daniel26127143/2wheelbalancecar/stable/README.md

### Latest Stable Release

**Recommended:**  👉 [**v0.2**](./v0.2) (Verified balance core)

* [v0.1 (Legacy Prototype)](./v0.1)
