daniel26127143/2wheelbalancecar/stable/v0.1/readme.md

# beta_v1: 不會倒下

# 此版本CODE已經可以達成自平衡小車的基礎穩定功能，並使用5ms的中斷系統。小車已能在室內環境中長時間保持平衡。

---

##  版本重點功能與成果

-   **系統穩定性：** 在 Kp, Ki, Kd 參數精確調校後，小車已實現**長時間穩定站立**（可維持 10 分鐘以上不倒）。
-   **控制核心：** 採用 **5ms Timer 中斷 (ISR)** 架構，確保 PID 運算精準且即時，避免了主迴圈 (Loop) I2C 通訊延遲的干擾。
-   **初版流程圖：** 提供了當前控制邏輯的初版流程圖作為後續優化的參考。

---

##  與教授討論後能夠改善的地方

此 beta 版本是未來進階控制的基礎所以是beta_v1。根據討論，未來會針對**控制連續性**和**效能監控**的優化方向：

### 1. 控制邏輯強化與角度判斷(流程圖方面)

-   **待優化項目：** 將 `Loop()` 與 `ISR` 中檢查是否傾倒的邏輯，統一改為**判斷角度是否超過預設閾值**來執行相應的動作，還有在中斷功能要檢查是否溢位。
-   **目標：** 讓判斷邏輯更精確，與控制系統高度整合。

### 2. 在ISR當中進行迴圈並且直接獲取MPU6050的角度(程式碼方面)

-   **待優化項目：** 嘗試在 **ISR 內部新增迴圈**，讓 PID 運算**持續執行**直到小車被拉回平衡點後才返回 `Loop()`。
-   **挑戰：** 需解決在 ISR 內**阻塞**、等待最新角度數據（DMP）的問題，避免破壞 5ms 的控制時序。

### 3. 效能與延遲監控

-   **監控機制：** 計劃使用 **LED** 來判斷 ISR 是否正常返回 `Loop()`，並透過觀察 LED 閃爍頻率來**計算 ISR 的實際工作時長**。

---
以下是本次測試的Youtube影片
https://www.youtube.com/watch?v=9Uyl_yrKQsg
