daniel26127143/2wheelbalancecar/flow/流程圖02.drawio.png

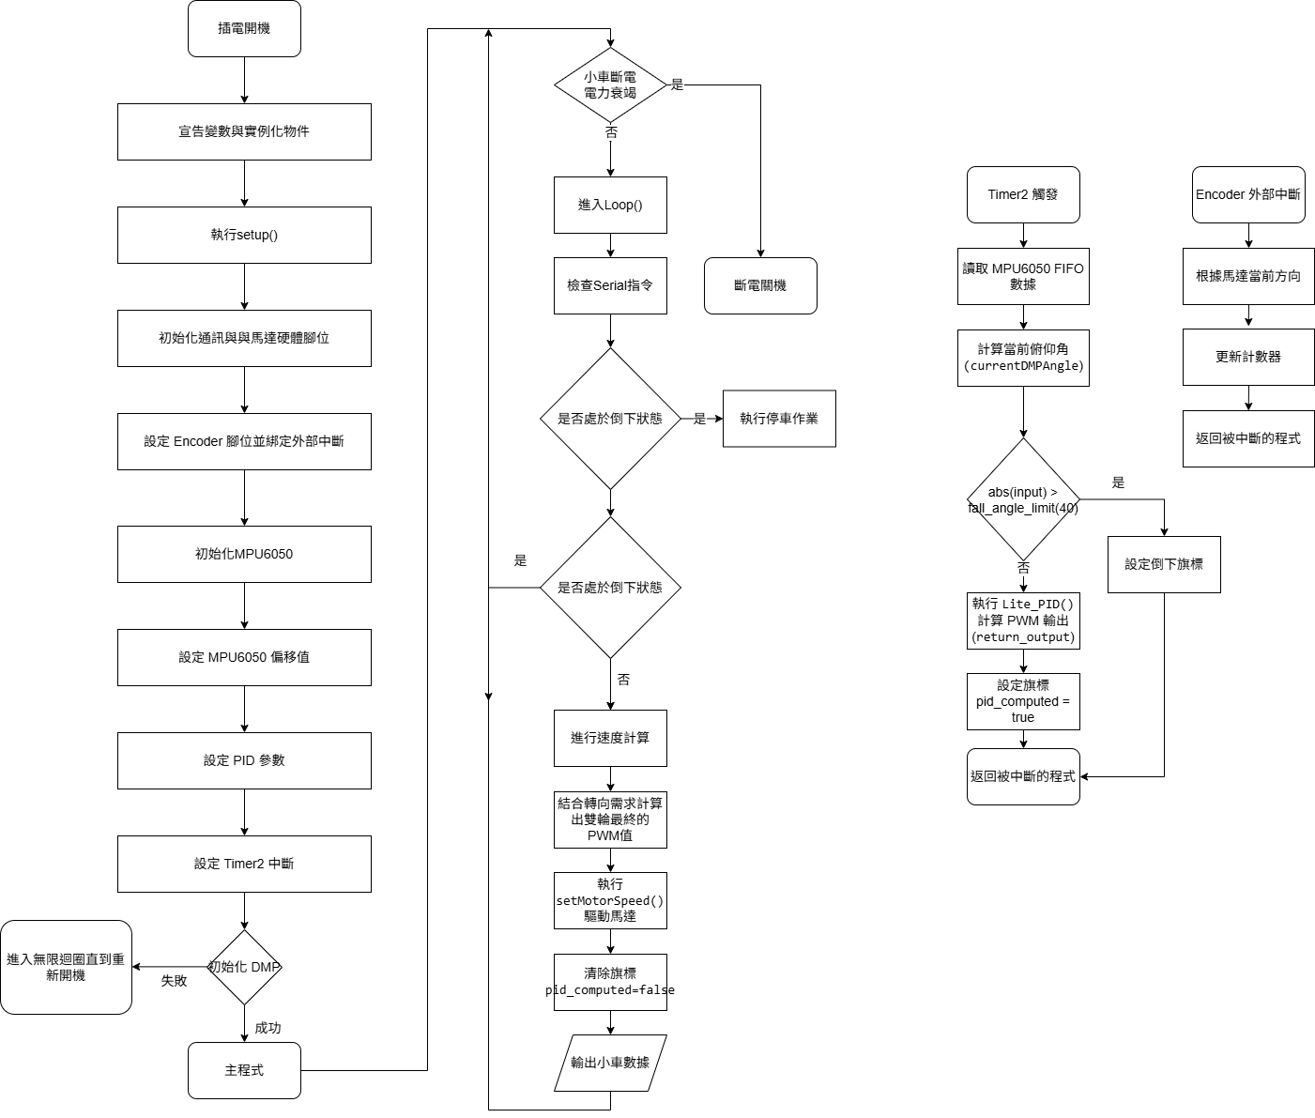
flow/流程圖02.drawio.png
