daniel26127143/2wheelbalancecar/python/logs/autotest_results.csv

time | label | vmax | vback | vmin | vmin_back | kp | kd | steer | hold | cycle | phase | n | speed_mean_cms | speed_sd_cms | speed_peak_cms | sa_sat_pct | pwm_mean | overshoot | emerg | fell | log | yaw_cmd | yaw_mean | yaw_sd | yaw_ratio
2026-10-13 21:17:21 | v34 | 7.2 | 3.5 | 6.5 | 3.0 | 2.8 | 40.0 | 0.0 | 5.0 | 1 | W | 17 | 3.482628983658124 | 3.5282171945574925 | 10.299433872177886 | 0.0 | 22.941176470588236 | 2.236111111111111 | 0 | 0 | telemetry_20261013_211706.csv
2026-10-13 21:17:48 | v34 | 7.2 | 3.5 | 6.5 | 3.0 | 2.8 | 40.0 | 0.0 | 5.0 | 1 | W | 17 | 4.048355581233925 | 3.8268114051558664 | 9.8219766728054 | 0.0 | 25.941176470588236 | 2.0 | 0 | 0 | telemetry_20261013_211706.csv
2026-10-13 21:18:09 | v34 | 7.2 | 3.5 | 6.5 | 3.0 | 2.8 | 40.0 | 0.0 | 5.0 | 1 | W | 17 | 3.2057840529295403 | 1.7512060729127128 | 6.8890253052315655 | 0.0 | 20.0 | 1.472222222222222 | 0 | 0 | telemetry_20261013_211706.csv
2026-10-13 21:33:05 | x35 | 7.2 | 3.5 | 6.5 | 3.0 | 2.8 | 40.0 | 0.0 | 6.0 | 1 | X | 22 | 2.663219053642626 | 3.472378624686737 | 9.003478616738283 | 0.0 | 21.272727272727273 | 3.7714285714285714 | 0 | 0 | telemetry_20261013_213248.csv
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
