daniel26127143/2wheelbalancecar/Experiments/testyawpitchrow.ino

#include <Wire.h>
#include "I2Cdev.h"
#include "MPU6050_6Axis_MotionApps20.h"
#include <PID_v1.h>
// 徑度角度的轉換常數
//const float DEG_TO_RAD = 0.0174533f; // (PI / 180.0) 因為原本就有定義了 重新定義會出錯先註解

// 分區 PWM 設定
float zone1_limit = 2 * DEG_TO_RAD;        // |input| < 2
float zone2_limit = 3 * DEG_TO_RAD;        // |input| < 3
float zone1_gain = 0.95;                   // 小角度修正比較弱
float zone2_gain = 1.0;                    // 中角度修正稍強
float zone3_gain = 1.1;                    // 大角度修正更強
float fall_angle_limit = 40 * DEG_TO_RAD;  // 超過 ±40 度就停車

// 用於扶正回復時的計數器
unsigned long recovery_counter = 0;

// MPU6050 與 DMP
MPU6050 mpu;
bool dmpReady = false;
uint8_t devStatus;
uint16_t packetSize;
uint16_t fifoCount;
uint8_t fifoBuffer[64];

// ISR 所需要的回傳值
volatile float return_output = 0.0;
volatile bool pid_computed = false;

// led 定義
const int led = A0;
Quaternion q;
VectorFloat gravity;
float ypr[3];

// 用於ISR和Loop中傳遞當前的角度和小車已倒下旗標
volatile float currentDMPAngle = 0.0;
volatile float currentYaw = 0.0;
volatile float currentPitch = 0.0;
volatile float currentRoll = 0.0;
volatile bool is_fallen = false;
int current_zone = 0;

// PID
double input, output, setpoint = -2.3 * DEG_TO_RAD;  // 電源線反方向設定
// double Kp = 50.0, Ki = 200, Kd = 2.4;   // 角度的
double Kp = 2350.0, Ki = 11459.0, Kd = 137.4;  // 更改為徑度的
PID pid(&input, &output, &setpoint, Kp, Ki, Kd, DIRECT);

// 馬達腳位
#define IN1M 7
#define IN2M 6
#define PWMA 9
#define IN3M 13
#define IN4M 12
#define PWMB 10
#define STBY 8

void initMotorPins() {
  pinMode(IN1M, OUTPUT);
  pinMode(IN2M, OUTPUT);
  pinMode(PWMA, OUTPUT);
  pinMode(IN3M, OUTPUT);
  pinMode(IN4M, OUTPUT);
  pinMode(PWMB, OUTPUT);
  pinMode(STBY, OUTPUT);
  digitalWrite(STBY, HIGH);
}

void stop() {
  setMotorSpeed(0);
}

void setMotorSpeed(float speed) {
  speed = constrain(speed, -255, 255);
  int pwm = abs(speed);
  if (pwm < 5) pwm = 0;

  if (speed < 0) {
    digitalWrite(IN1M, HIGH);
    digitalWrite(IN2M, LOW);
    digitalWrite(IN3M, HIGH);
    digitalWrite(IN4M, LOW);
  } else {
    digitalWrite(IN1M, LOW);
    digitalWrite(IN2M, HIGH);
    digitalWrite(IN3M, LOW);
    digitalWrite(IN4M, HIGH);
  }
  analogWrite(PWMA, pwm);
  analogWrite(PWMB, pwm);
}

void setup() {
  Serial.begin(9600);  // 配合藍牙
  Wire.begin();

  //加速 I2C 到 400kHz，這是 ISR 讀取不當機的關鍵
  Wire.setClock(400000);

  initMotorPins();
  pinMode(led, OUTPUT);
  digitalWrite(led, LOW);  // 確保起始是滅的

  mpu.initialize();
  devStatus = mpu.dmpInitialize();

  mpu.setXAccelOffset(-3353);
  mpu.setYAccelOffset(97);
  mpu.setZAccelOffset(123);
  mpu.setXGyroOffset(81);
  mpu.setYGyroOffset(-30);
  mpu.setZGyroOffset(63);

  if (devStatus == 0) {
    mpu.setDMPEnabled(true);
    dmpReady = true;
    packetSize = mpu.dmpGetFIFOPacketSize();
    Serial.println("DMP 啟動完成");
  } else {
    Serial.print("DMP Fail: ");
    Serial.println(devStatus);
    while (1)
      ;
  }

  pid.SetMode(AUTOMATIC);
  pid.SetOutputLimits(-255, 255);
  pid.SetSampleTime(10);

  // TIMER2設定
  cli();
  TCCR2A = 0;
  TCCR2B = 0;
  TCNT2 = 0;
  OCR2A = 124;
  TCCR2A |= (1 << WGM21);
  TCCR2B |= (1 << CS22);
  TIMSK2 |= (1 << OCIE2A);
  sei();
}
ISR(TIMER2_COMPA_vect) {
  // 宣告中斷秒數的變數
  static int count = 0;
  count++;

  // 檢查是否到中斷時間
  if (count < 10) {
    return;
  }
  count = 0;

  // 以下進入真正的中斷
  sei();
  digitalWrite(led, HIGH);

  // 宣告用於三筆平均濾波的變數
  static float angleBuffer[3] = { 0.0, 0.0, 0.0 };
  static int idx = 0;

  // 讀取 FIFO
  fifoCount = mpu.getFIFOCount();
  if (fifoCount == 1024) {
    mpu.resetFIFO();
    digitalWrite(led, LOW);
    return;
  }

  if (mpu.dmpGetCurrentFIFOPacket(fifoBuffer)) {
    mpu.dmpGetQuaternion(&q, fifoBuffer);
    mpu.dmpGetGravity(&gravity, &q);
    float ypr_temp[3];
    mpu.dmpGetYawPitchRoll(ypr_temp, &q, &gravity);
    // 取得原始徑度
    float raw_angle = ypr_temp[2];
    currentYaw = ypr_temp[0];
    currentPitch = ypr_temp[1];
    currentRoll = ypr_temp[2];
    // 三筆平均濾波
    angleBuffer[idx] = raw_angle;
    idx = (idx + 1) % 3;
    currentDMPAngle = (angleBuffer[0] + angleBuffer[1] + angleBuffer[2]) / 3.0;

    input = currentDMPAngle;
  } else {
    digitalWrite(led, LOW);
    return;
  }

  // 判斷PID計算和是否傾倒偵測
  if (!is_fallen) {
    // 傾倒偵測 如果小車角度已經超過設定的傾倒角度 設定倒下旗標
    if (abs(input) > fall_angle_limit) {
      is_fallen = true;      // 設定倒下旗標
      return_output = 0;     // 停止馬達
      recovery_counter = 0;  // 清除回正計數器
    }
    // 計算PID並且使用分區增益
    else {
      pid.Compute();
      // 分區增益邏輯
      current_zone = 0;
      if (abs(input) < zone1_limit) {
        output *= zone1_gain;
        current_zone = 1;
      } else if (abs(input) < zone2_limit) {
        output *= zone2_gain;
        current_zone = 2;
      } else {
        output *= zone3_gain;
        current_zone = 3;
      }

      output = constrain(output, -255, 255);
      return_output = output;
    }
  }
  // 已經倒下需要判斷是否扶正，並且讓recovery_counter計數
  else {
    return_output = 0;  // 確保馬達完全不動
    // 判斷是否扶正(與中心 < 5 角度)
    if (abs(input - setpoint) < (5 * DEG_TO_RAD)) {
      recovery_counter++;  // 回復計數器++

      // 判斷是否已經扶正1秒鐘 (10ms x 100times = 1000ms)
      if (recovery_counter >= 100) {
        is_fallen = false;     // 取消傾倒狀態
        recovery_counter = 0;  // 回復計數器歸零

        // 重置 PID 積分項 (避免暴衝)
        pid.SetMode(MANUAL);
        pid.SetMode(AUTOMATIC);
      }
    } else {
      //recovery_counter = 0;
    }
  }

  // ==========================================================

  // 放置PID計算完成旗標，告訴Loop可以正常工作
  pid_computed = true;
  digitalWrite(led, LOW);
}

void loop() {
  // 1. 傾倒檢查
  if (is_fallen) {
    stop();
  }
  
  // 2. 執行馬達 (只有當 ISR 算好時才動作)
  if (pid_computed) {
    float motor_cmd = return_output;
    setMotorSpeed(motor_cmd); // 如果不想馬達動，改成 setMotorSpeed(0);
    pid_computed = false;
  }

  // 3. 序列埠列印 (修改成您想要的格式)
  static unsigned long lastPrint = 0;
  if (millis() - lastPrint > 100) { // 改成 100ms 印一次，太快眼睛會看不清楚
    lastPrint = millis();
    
    // 轉換成角度 (原本是徑度)
    
    Serial.print("yaw = ");
    Serial.print(currentYaw * 57.296); 
    Serial.print("\t");
    
    Serial.print("pitch = ");
    Serial.print(currentPitch * 57.296);
    Serial.print("\t");
    
    Serial.print("roll = ");
    Serial.println(currentRoll * 57.296);
  }
}
