daniel26127143/2wheelbalancecar/(commit log)

2025-07-16 250716
    還不行平衡只可以簡單的前後嚕
2025-07-20 測試左右輪工作狀態程式
2025-07-24 測試兩輪工作
2025-07-25 參考程式碼
2025-07-27 PID controll
2025-07-27 增加KI控制 增加倒地時停止馬達 使用MPU6050的資料三筆做平均Input
2025-07-31 小車藍芽測試程式確認是否有正常連上
2025-08-04 將fifoCount If判斷改成While判斷
2025-08-11 調整PIDKp = 63.0, Ki = 220.0, Kd = 1.6;
2025-08-17 新增使用timer2中斷
2025-08-25 新增分區增益
2025-09-12 PID中斷 有延遲問題
2025-10-01 中斷堵塞問題解決
2025-10-05 重新調整PID參數 可以堅持10分鐘以上不倒了 新增真正的中段功能
2025-10-05 新增流程圖
2025-10-05 Rename 未命名绘图.drawio (2).png to 流程圖.png
2025-10-07 Create 歷史版本
2025-10-07 上傳v1版本codeEp
2025-12-11 把DMP獲取數據改道ISR裡面，並且把setmotor那
2025-12-18 更改角度設定 把角度更改成徑度
    教授說這樣子比較好
2025-12-25 我也不知道改了啥
2026-01-01 新增傾倒回正重啟機制
2026-01-08 在監控窗裡面輸出A或D可以左右轉
2026-01-28 將PID修改成簡化版本自己寫的版本
2026-01-28 更新自己寫的精簡版PID 然後更改對應的PID參數
2026-02-24 測試encoder
    目前的功能是兩輪轉10秒 比較兩輪的ticks 然後給出修改的ratio
2026-03-05 還沒修改完這只是單純上傳
2026-03-06 修好平衡時候的BUG ROLL三段PID 還需要調整
2026-03-12 解決掉setpoint在非巡航模式下會移動的問題
2026-03-12 歷史文件上傳
2026-03-12 260312流程圖
2026-03-19 修改PID的參數
2026-06-25 修改了一大堆
2026-07-02 把導航模式放進中斷服務程式 修改導航程式邏輯
2026-07-09 修改PID 的D直接從6050身上獲取 然後把arduino放到中間那層 把電池往上放 換了一個新的電池
2026-08-13 修改最低PWM 和PID
2026-09-07 修改直立環 速度環 重新測試了PID參數 還沒更新移動code
2026-10-13 大調整參數和調整整體的code架構
